bigtreetech/Panda_Breath/readme.md

## Introduction
BIQU Panda Breath is a smart chamber heater & filter designed for Bambu Lab printers. Its 300W PTC heater delivers fast, uniform chamber heating to prevent warping, strengthen layer adhesion in engineering materials (ABS, ASA, PC, PA...), and ensure perfect first-layer adhesion across all filaments. <br>The dual HEPA and activated carbon filtration system actively captures VOCs and fine particles from the chamber, delivering clean, heated air for odor-free printing that protects your health and your family's.

## Key Features
- **Easy Firmware Updates**: Includes quick-flash interface for DIY firmware burning and future upgrades.
- **Main Power Switch**: Convenient one-touch total power cutoff.
- **Quick-Access Controls**: Dedicated function buttons for streamlined operation.
- **Automatic Start/Stop**: Intelligently manages chamber heating and air filtration by monitoring the print bed’s temperature in real time. 
- **High-Temperature Capability**: Reaches up to 60°C chamber temperature, ideal for engineering-grade filaments.
- **Wireless Control**: Onboard ESP32 WiFi module enables remote operation.
- **Rapid Heating**: High-power PTC heater ensures fast temperature ramp-up.
- **Wide Voltage Compatibility**: Broad input voltage range maximizes printer compatibility.

For instruction manual, please visit BTT Wiki：
https://bttwiki.com/Panda_Breath.html


# Copyright

These files and the designs contained therein are copyright (c) 2025 BIQU.

These files and the designs contained therein are additionally licensed under **CC-BY-NC-ND-4.0**.
