bigtreetech/Panda_Breath/3D Model/Mounting solution/P1S/Riser/Side L.STEP

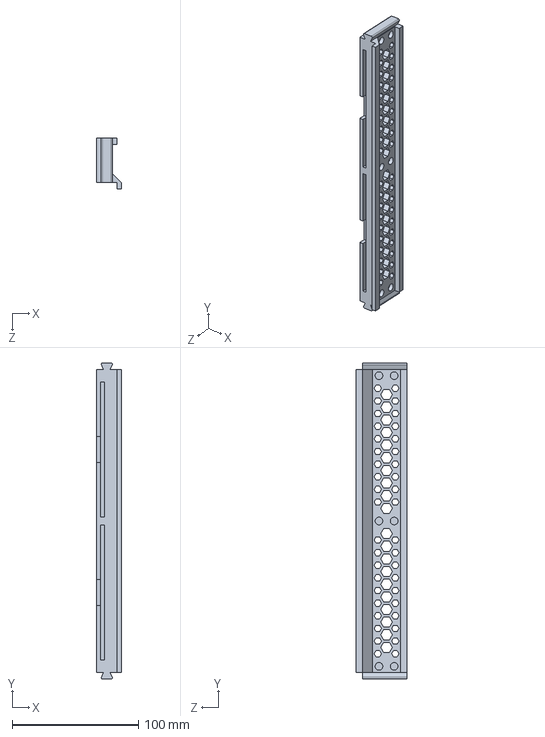
[picture p1: CAD file, 2025-12-24]
3D Model/Mounting solution/P1S/Riser/Side L.STEP
19.5 x 250.0 x 40.0 mm
