bigtreetech/Panda_Breath/3D Model/Mounting solution/P2S/Fixed Bracket Part2.STL

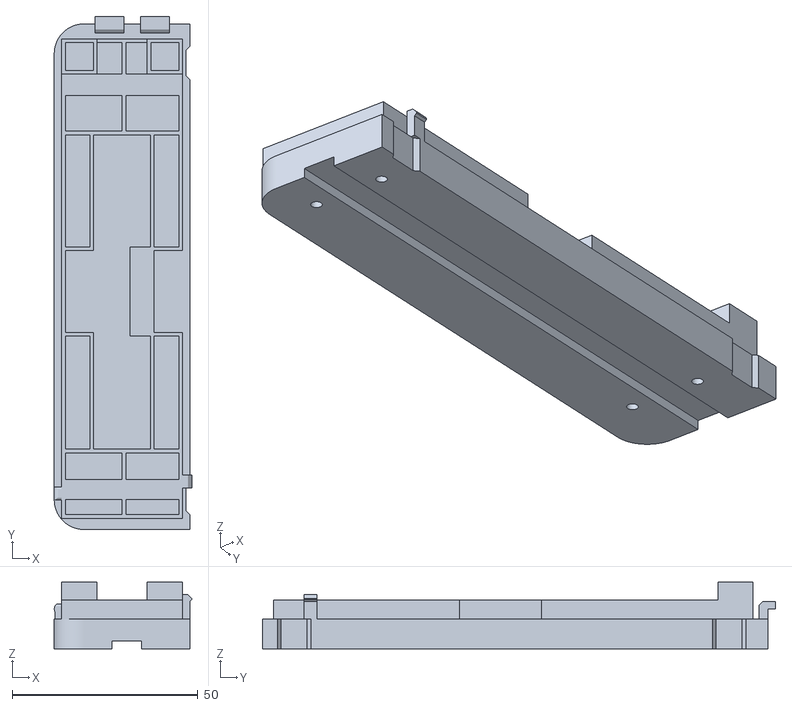
[picture p2: CAD file, 2026-07-09]
3D Model/Mounting solution/P2S/Fixed Bracket Part2.STL
37.0 x 138.0 x 18.0
