bigtreetech/Panda_Breath/3D Model/Mounting solution/P2S/Riser/Front_Corner_2.STL

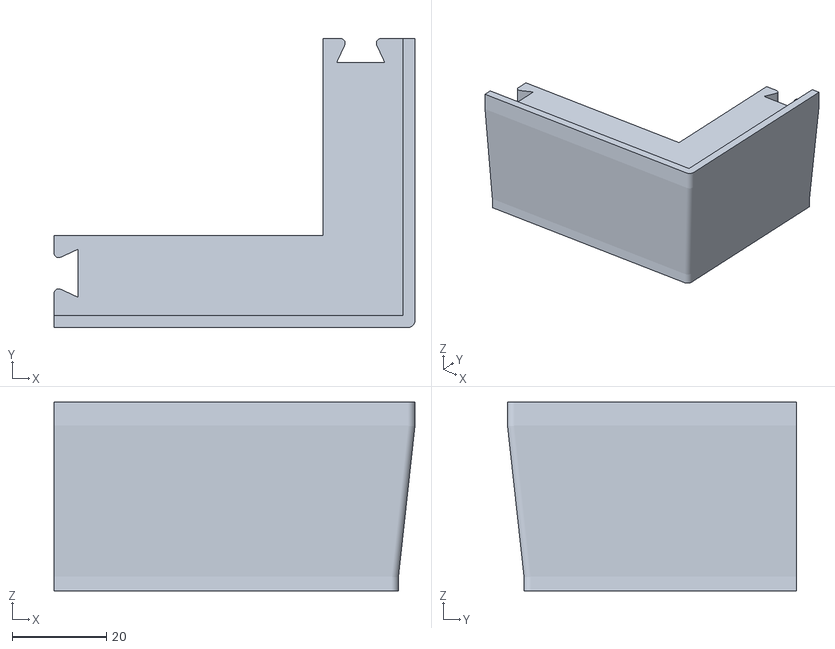
[picture p3: CAD file, 2026-07-09]
3D Model/Mounting solution/P2S/Riser/Front_Corner_2.STL
76.5 x 61.3 x 40.0
