bigtreetech/Panda_Breath/3D Model/Mounting solution/X1C/Riser/Front.STEP

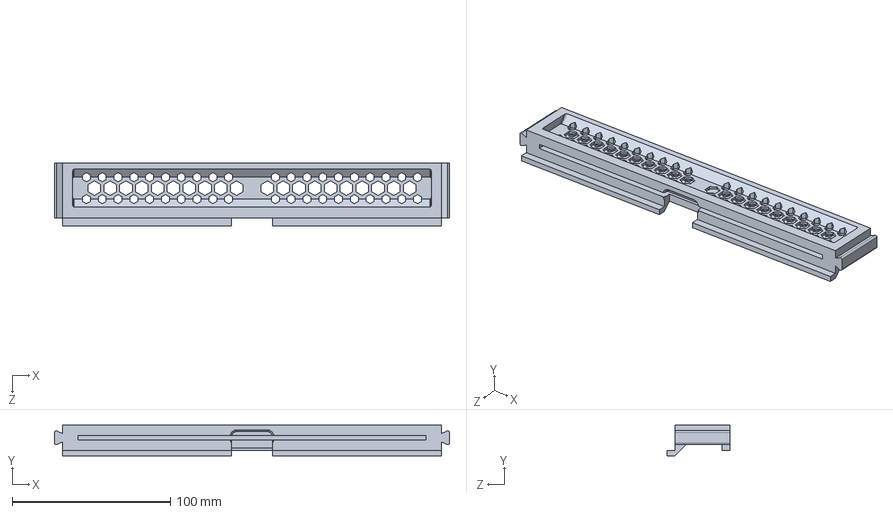
[picture p5: CAD file, 2025-12-24]
3D Model/Mounting solution/X1C/Riser/Front.STEP
250.0 x 19.5 x 40.0 mm
