bigtreetech/Panda_Breath/3D Model/Mounting solution/P1S/Riser/Front SeaL.STEP

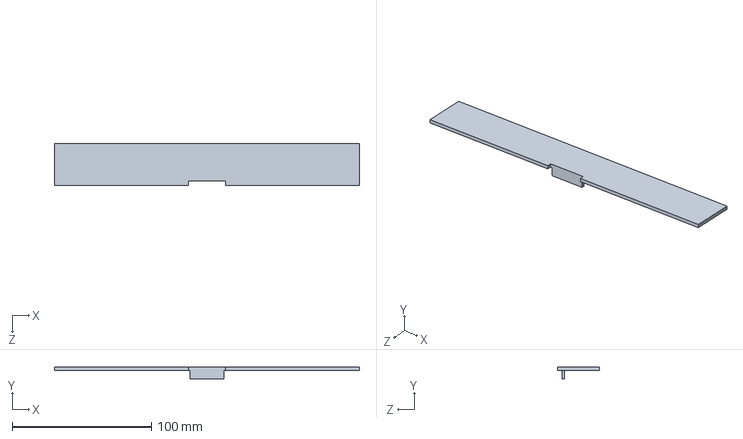
[picture p7: CAD file, 2025-12-24]
3D Model/Mounting solution/P1S/Riser/Front SeaL.STEP
219.3 x 8.40 x 30.0 mm
