bigtreetech/Panda_Breath/3D Model/Mounting solution/P2S/Fixed Bracket Part1.STL

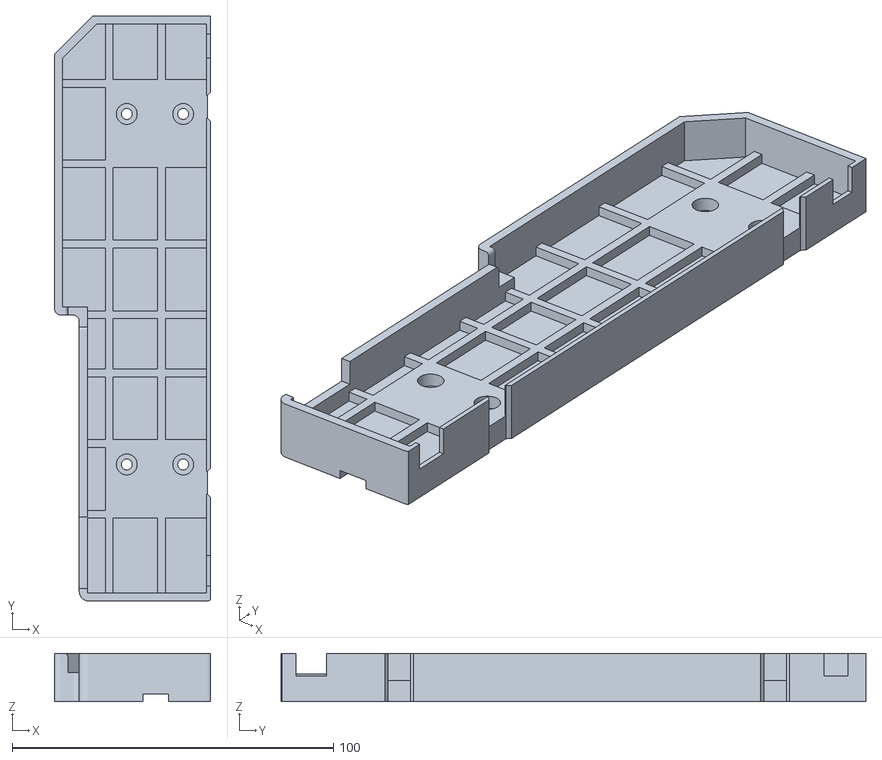
[picture p8: CAD file, 2026-07-09]
3D Model/Mounting solution/P2S/Fixed Bracket Part1.STL
48.6 x 182.1 x 15.0
