bigtreetech/Panda_Breath/3D Model/Mounting solution/SnapMaker U1/Clamping Bracket Compatible with Panda Breath V1.1/base bracket.STL

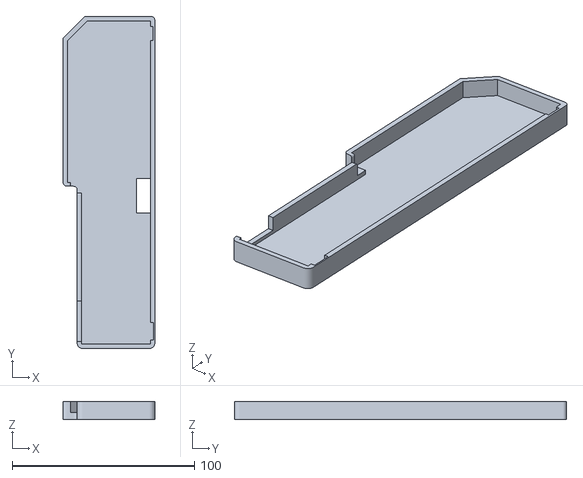
[picture p9: CAD file, 2026-07-09]
3D Model/Mounting solution/SnapMaker U1/Clamping Bracket Compatible with Panda Breath V1.1/base bracket.STL
50.3 x 182.1 x 10.0
