bigtreetech/Panda_Breath/3D Model/Mounting solution/X1C/Riser/Side Seal x4.STEP

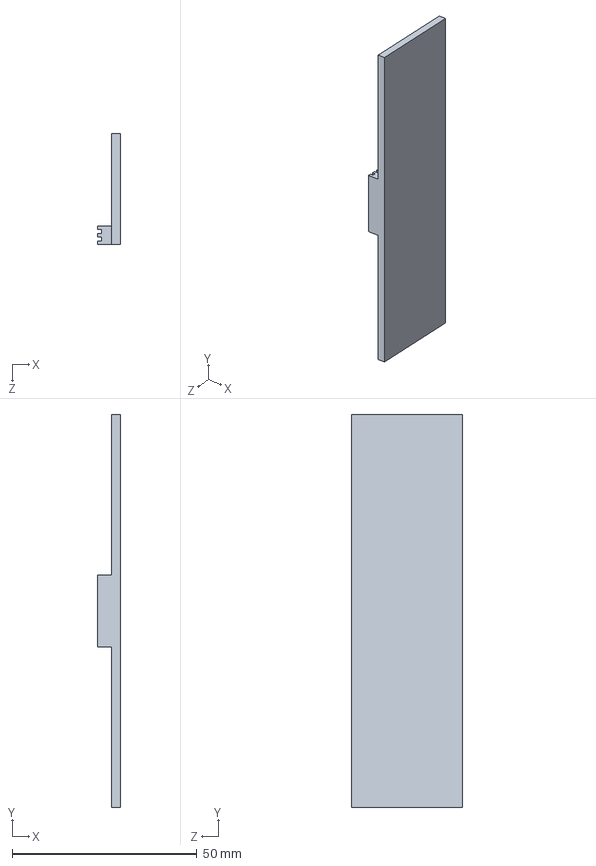
[picture p10: CAD file, 2025-12-24]
3D Model/Mounting solution/X1C/Riser/Side Seal x4.STEP
6.15 x 106.3 x 30.0 mm
