bigtreetech/Panda_Breath/3D Model/Mounting solution/P2S/Riser/Rear_Corner_Long.STL

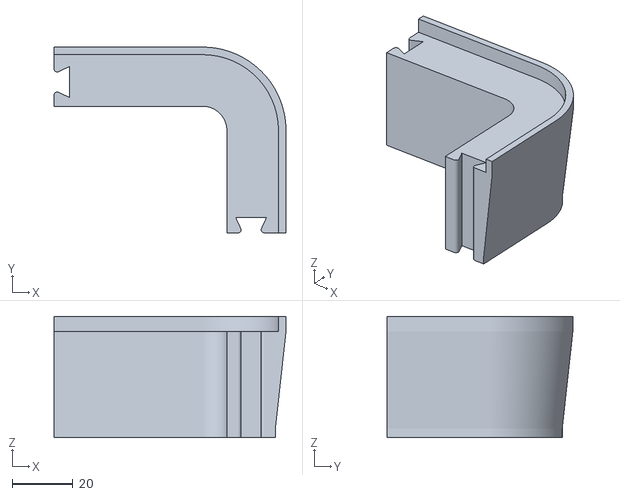
[picture p11: CAD file, 2026-07-09]
3D Model/Mounting solution/P2S/Riser/Rear_Corner_Long.STL
76.5 x 61.2 x 40.0
