bigtreetech/Panda_Breath/3D Model/Mounting solution/SnapMaker U1/Clamping Bracket Compatible with Panda Breath V1.1/expansion block x2.STL

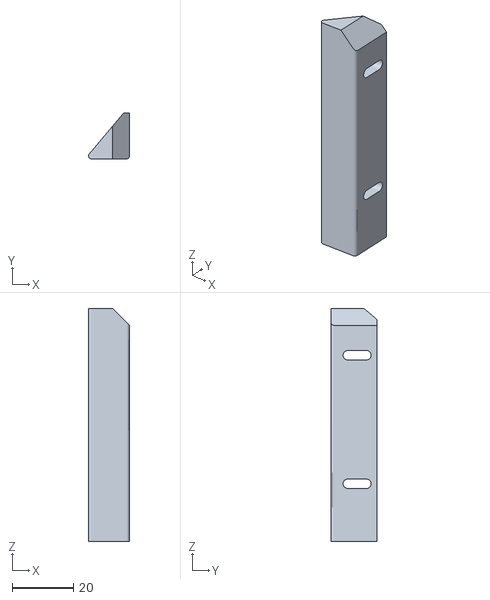
[picture p12: CAD file, 2025-12-31]
3D Model/Mounting solution/SnapMaker U1/Clamping Bracket Compatible with Panda Breath V1.1/expansion block x2.STL
13.4 x 15.0 x 76.0
