bigtreetech/Panda_Breath/3D Model/Mounting solution/P1S/Riser/Corner B R.STEP

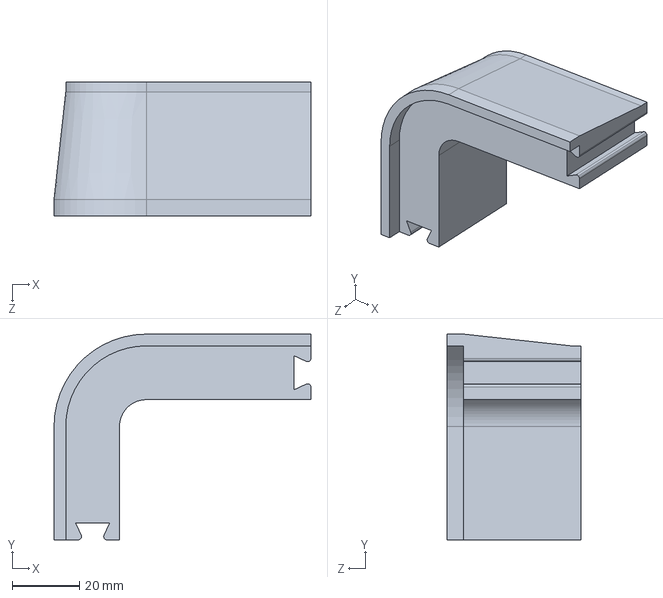
[picture p13: CAD file, 2025-12-24]
3D Model/Mounting solution/P1S/Riser/Corner B R.STEP
76.5 x 61.3 x 40.0 mm
