bigtreetech/Panda_Breath/3D Model/Mounting solution/P2S/Riser/Rear_Corner_Short.STL

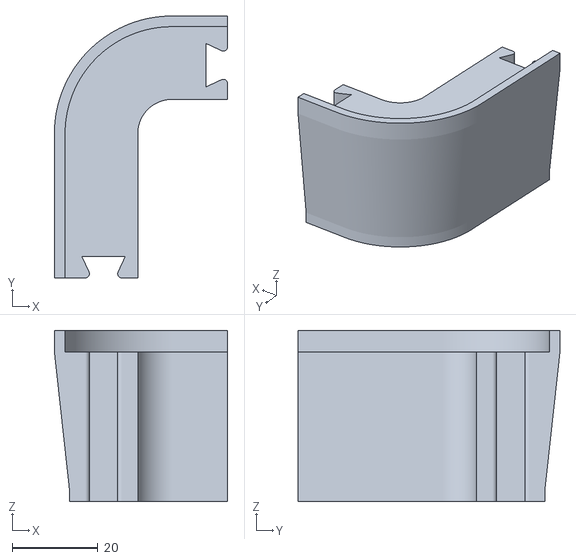
[picture p14: CAD file, 2026-07-09]
3D Model/Mounting solution/P2S/Riser/Rear_Corner_Short.STL
40.5 x 61.2 x 40.0
