bigtreetech/Panda_Breath/3D Model/Mounting solution/X1C/Riser/Cable clamp.STL

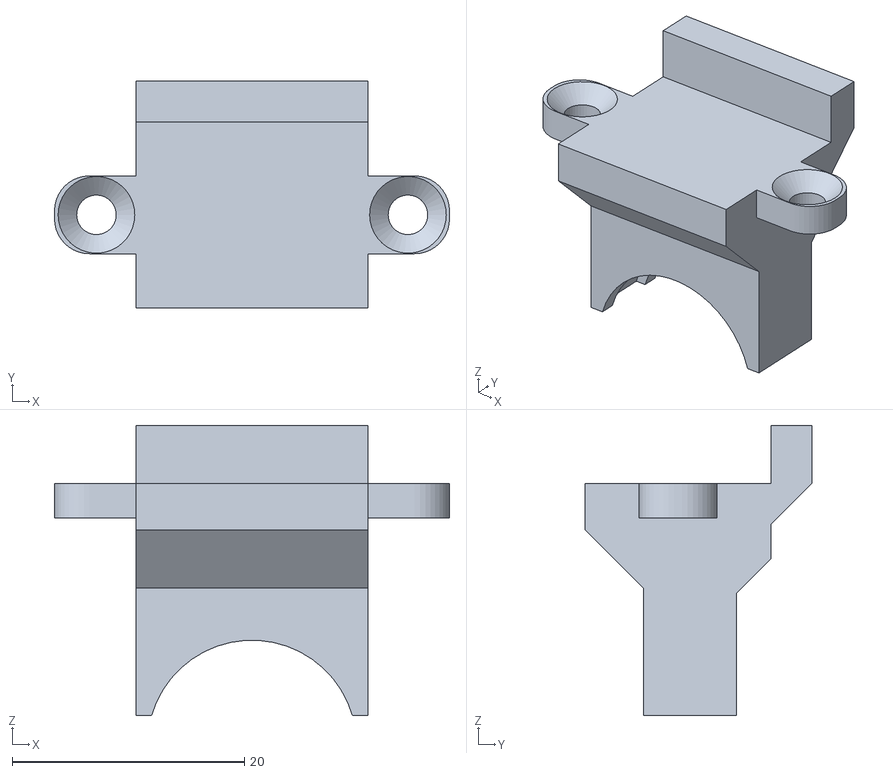
[picture p15: CAD file, 2025-12-24]
3D Model/Mounting solution/X1C/Riser/Cable clamp.STL
34.0 x 19.5 x 25.0
