bigtreetech/Panda_Breath/3D Model/Mounting solution/P2S/Riser/Rear_Frame_Plate.STL

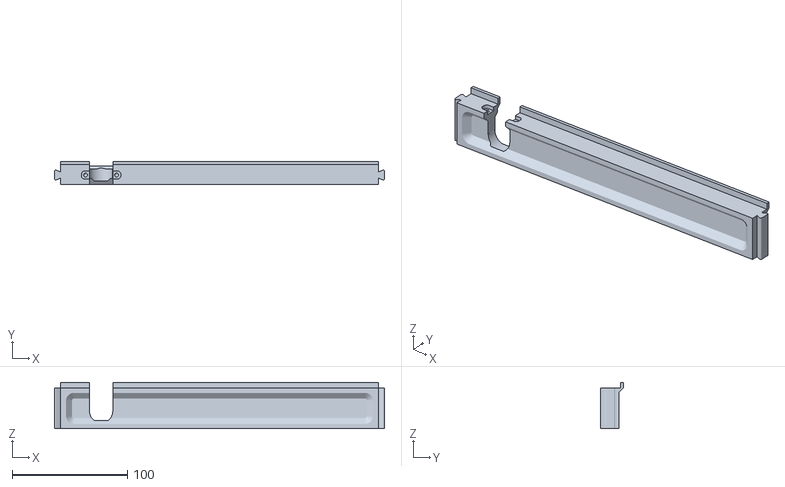
[picture p16: CAD file, 2026-07-09]
3D Model/Mounting solution/P2S/Riser/Rear_Frame_Plate.STL
286.0 x 19.5 x 40.0
