bigtreetech/Panda_Breath/(list of files, cad)

Other CAD files:
3D Model/Mounting solution/P2S/Riser/Front_Cover_Plate.STL
3D Model/Mounting solution/P1S/Riser/Side R.STEP
3D Model/Mounting solution/X1C/Riser/Corner F R.STEP
3D Model/Mounting solution/P2S/Riser/Front_Plate.STL.STL
3D Model/Mounting solution/P2S/Riser/Side_Panel_x2.STL
3D Model/Mounting solution/P1S/Riser/Corner F L.STEP
3D Model/Mounting solution/P2S/Riser/Side_Cover_Plate_x4.STL
3D Model/Mounting solution/X1C/Riser/Corner F L.STEP
3D Model/Mounting solution/P1S/Riser/Coner B L.STL
3D Model/Mounting solution/P1S/Riser/Corner B L.STEP
3D Model/Mounting solution/X1C/Riser/Corner B L.STEP
3D Model/Mounting solution/P1S/Riser/Corner F R.STEP
3D Model/Mounting solution/X1C/Riser/Side R.STEP
3D Model/Mounting solution/P1S/Riser/Cable Clamb.STEP
3D Model/Mounting solution/X1C/Riser/Cable Clamb.STEP
3D Model/Mounting solution/P1S/Riser/Back.STL
3D Model/Mounting solution/P1S/Riser/Corner B L.STL
3D Model/Mounting solution/P1S/Riser/Corner B R.STL
3D Model/Mounting solution/P1S/Riser/Corner F L.STL
3D Model/Mounting solution/P1S/Riser/Corner F R.STL
3D Model/Mounting solution/P1S/Riser/Front Seal.STL
3D Model/Mounting solution/P1S/Riser/Front.STL
3D Model/Mounting solution/P1S/Riser/Side L.STL
3D Model/Mounting solution/P1S/Riser/Side R.STL
3D Model/Mounting solution/P1S/Riser/Side Seal x4.STL
3D Model/Mounting solution/SnapMaker U1/Clamping Bracket Compatible with Panda Breath V1.0(1)/Expansion bracket.STL
3D Model/Mounting solution/SnapMaker U1/Clamping Bracket Compatible with Panda Breath V1.0/base bracket.STL
3D Model/Mounting solution/X1C/Printed Nut for X1C.STEP
3D Model/Mounting solution/X1C/Riser/Back.STL
3D Model/Mounting solution/X1C/Riser/Corner B R.STL
3D Model/Mounting solution/X1C/Riser/Corner F L.STL
3D Model/Mounting solution/X1C/Riser/Corner F R.STL
3D Model/Mounting solution/X1C/Riser/Front Seal.STL
3D Model/Mounting solution/X1C/Riser/Front.STL
3D Model/Mounting solution/X1C/Riser/Side L.STL
3D Model/Mounting solution/X1C/Riser/Side R.STL
3D Model/Mounting solution/X1C/Riser/Side Seal x4.STL
