bigtreetech/Panda_Breath/(commit log)

2025-12-31 add Mounting solution for SnapMaker U1
    [Expansion bracket.STL, base bracket.STL, expansion block.STL]
2026-02-09 add reference cad
2026-02-09 modify reference cad
2026-04-09 modify Corner B
    [Corner B L.STL]
2026-07-09 update mounting solution
    [Coner B L.STL, Expansion bracket.STL, Fixed Bracket Part1.STL, Fixed Bracket Part2.STL, Front_Corner_1.STL, Front_Corner_2.STL, Front_Cover_Plate.STL, Front_Plate.STL.STL]
