bigtreetech/Panda_Breath/(notices)

Notices in the files:
readme.md:
License: CC BY-NC-ND 4.0
